SemKirkels/RC_Car/README.md

# RC Car

## Hardware Block Design

RC_BlockDesign-HARDWARE (2)


## Software Block Design


## Pinout

<p align="center">
  Screenshot from 2026-04-26 17-21-20
</p>
