SemKirkels/RC_Car/hardware/datasheets/README.md

# links datasheet

## Drivers

* [drv8306](https://www.ti.com/product/DRV8306?keyMatch=DRV8306&tisearch=universal_search&usecase=GPN-ALT) 
* [mcf8329a](https://www.ti.com/product/MCF8329A)
* [mcf8329a-q1](https://www.ti.com/product/MCF8329A-Q1) (voorkeur)
* [mcf8329hs-q1](https://www.ti.com/product/MCF8329HS-Q1)
* [mct8329a](https://www.ti.com/product/MCT8329A)

## Sensors
* [TOF](https://www.adafruit.com/product/3967)
* [AmbientTEMP](https://www.mouser.be/ProductDetail/Microchip-Technology/MCP9808-E-MS?qs=fgHA1UgJI8CbPdrkP5zjqQ%3D%3D)
* [TEMP](https://www.mouser.be/ProductDetail/Microchip-Technology/MCP9600-E-MX?qs=ZEMkBHnybREkP7PCRsOOMQ%3D%3D)
* [BMC](https://www.mouser.be/ProductDetail/Texas-Instruments/BQ7692006PW?qs=MJut%252BdqOEgjXPi0Ty9wSKA%3D%3D)

## Voltage Regulator
* [3.3VLDO](https://www.mouser.be/ProductDetail/Analog-Devices/LT1764EQPBF?qs=ytflclh7QUW3%252BUOpCc3roQ%3D%3D)
* [5VBuckConverter](https://www.mouser.be/ProductDetail/Texas-Instruments/LM2596SX-5.0-NOPB?qs=X1J7HmVL2ZGZ5T4VcWdmNw%3D%3D)

## GPIO
* [LedDriver](https://www.mouser.be/ProductDetail/Diodes-Incorporated/BCR421UW6Q-7?qs=7rrmt5iGdWdedcb2M%252BEvjA%3D%3D)

## MOSFET halfbridge
* [PSMN4R2-40VSHX](https://www.mouser.be/ProductDetail/Nexperia/PSMN4R2-40VSHX?qs=GCAb4wyKXLKP4GTVQY42wA%3D%3D)

## MOSFET BMC
* [SQJ422EP-T1_BE3](https://www.mouser.be/ProductDetail/Vishay-Siliconix/SQJ422EP-T1_BE3?qs=zW32dvEIR3s9%2FaA%2FvimzvQ%3D%3D)

## Fuze
* [PTS18126V300](https://www.eaton.com/content/dam/eaton/products/electronic-components/resources/data-sheet/eaton-pts1812-6-60-volt-dc-surface-mount-resettable-ptc-data-sheet.pdf)
* [3555-2](https://www.mouser.be/ProductDetail/Keystone-Electronics/3555-2?qs=fP5bVVCrK%2FcbaGNcd%2BfxHA%3D%3D)
