SemKirkels/RC_Car/hardware/BOM_PCB.xlsx

Categorie | Component | Partnummer | website | Aantal | Opmerkingen | prijs per stuk(€) | prijs 1 PCB
Driver | MCF8329A-Q1 | MCF8329A-Q1 | TI (https://www.ti.com/product/DRV8306?keyMatch=DRV8306&tisearch=universal_search&usecase=GPN-ALT) | 1 | Voorkeurscontroller | 1.68 | 1.68
Sensor | TOF | Adafruit 3967 | Adafruit (https://www.adafruit.com/product/3967) | 3 | Time-of-Flight afstandssensor | 12.92 | 38.76
Sensor | AmbientTEMP | MCP9808-E-MS | Mouser (https://www.mouser.be/ProductDetail/Microchip-Technology/MCP9808-E-MS?qs=fgHA1UgJI8CbPdrkP5zjqQ%3D%3D) | 1 | Temperatuur sensor omgeving | 1.2 | 1.2
Sensor | TEMP | MCP9600-E-MX | Mouser (https://www.mouser.be/ProductDetail/Microchip-Technology/MCP9600-E-MX?qs=ZEMkBHnybREkP7PCRsOOMQ%3D%3D) | 1 | Temperatuur sensor | 7.56 | 7.56
Sensor | BMC | BQ7692006PW | Mouser (https://www.mouser.be/ProductDetail/Texas-Instruments/BQ7692006PW?qs=MJut%252BdqOEgjXPi0Ty9wSKA%3D%3D) | 1 | Battery Management Controller | 3.6 | 3.6
Voltage Regulator | 3.3V LDO | LT1764EQPBF | Mouser (https://www.mouser.be/ProductDetail/Analog-Devices/LT1764EQPBF?qs=ytflclh7QUW3%252BUOpCc3roQ%3D%3D) | 2 | LDO regulator 3.3V | 12.29 | 24.58
Voltage Regulator | 5V Buck Converter | LM2596SX-5.0-NOPB | Mouser (https://www.mouser.be/ProductDetail/Texas-Instruments/LM2596SX-5.0-NOPB?qs=X1J7HmVL2ZGZ5T4VcWdmNw%3D%3D) | 1 | Step-down converter 5V | 5.16 | 5.16
GPIO | LED Driver | BCR421UW6Q-7 | Mouser (https://www.mouser.be/ProductDetail/Diodes-Incorporated/BCR421UW6Q-7?qs=7rrmt5iGdWdedcb2M%252BEvjA%3D%3D) | 2 | LED driver IC | 0.292 | 0.584
MOSFET Halfbridge | PSMN4R2-40VSHX | PSMN4R2-40VSHX | Mouser (https://www.mouser.be/ProductDetail/Nexperia/PSMN4R2-40VSHX?qs=GCAb4wyKXLKP4GTVQY42wA%3D%3D) | 3 | N-channel MOSFET halfbridge | 2.25 | 6.75
MOSFET BMC | SQJ422EP-T1_BE3 | SQJ422EP-T1_BE3 | Mouser (https://www.mouser.be/ProductDetail/Vishay-Siliconix/SQJ422EP-T1_BE3?qs=zW32dvEIR3s9%2FaA%2FvimzvQ%3D%3D) | 2 | MOSFET voor BMC | 1.94 | 3.88
Fuze | PTS18126V300 | PTS18126V300 | Mouser (https://www.mouser.be/ProductDetail/Eaton-Electronics/PTS18126V300?qs=QmibqUXyDhQSUADtV47rkw%3D%3D) | 3 | Resettable PTC fuse | 0.215 | 0.645
Fuze | 3555-2 | 3555-2 | Mouser (https://www.mouser.be/ProductDetail/Keystone-Electronics/3555-2?qs=fP5bVVCrK%2FcbaGNcd%2BfxHA%3D%3D) | 1 | fuseholder | 1.31 | 1.31
 |  |  |  |  |  | totaal | 95.709
