SemKirkels/RC_Car/hardware/BOM_RC_CAR.xlsx

CONRAD RC car
Art.naam / omschrijving / Product description | Art.code bij leverancier / Product code | Bestelhoeveelheid en -eenheid (pcs, kg, ...) / Quantity and order unit | Eenheidsprijs (excl. BTW) en munteenheid / Unit price (excl. VAT) | link
Hyper Go MTX10 monstertruck Brushless 1:10 ARTR zwart/blauw | 3339742 - 62 | 1 | €243.80 | https://www.conrad.be/nl/p/hyper-go-mtx10-monstertruck-brushless-1-10-artr-zwart-blauw-3339742.html
11,1 V LiPo-accu 5000 mAh 50 C | 2160923 - 62 | 1 | €37.18 | https://www.conrad.be/nl/p/11-1-v-lipo-accu-5000-mah-50-c-2160923.html
VOLTCRAFT XT60 LiPo Balancer Board | 1516986 - 62 | 1 | €21.48 | https://www.conrad.nl/nl/p/voltcraft-xt60-lipo-balancer-board-uitvoering-lader-xt60-steeksysteem-uitvoering-accupack-bananenstekker-geschikt-voor-1516986.html
Microsoft QAS-00009 N/A | 3384949 - 62 | 1 | €47.93 | https://www.conrad.nl/nl/p/microsoft-qas-00009-n-a-3384949.html
 |  |  | €350.39
