SemKirkels/RC_Car/hardware/RC_Car_PCB/RC_Car_PCB.step

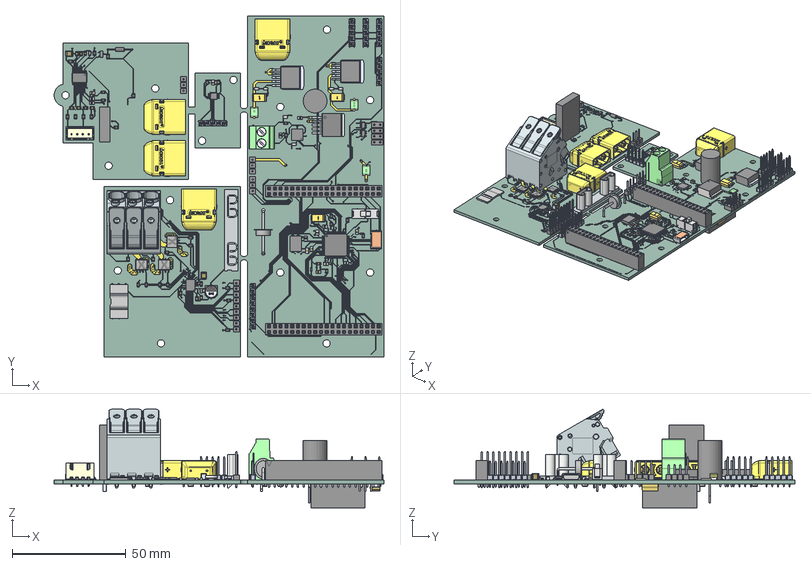
[picture p1: CAD file, 2026-05-19]
hardware/RC_Car_PCB/RC_Car_PCB.step
145.0 x 150.0 x 43.4 mm
solidBody x 17
solidTop x 17
solidTerminal1 x 7
solidTerminal2 x 7
solidTerminal3 x 7
CRCW08052M00JNEA x 6
LeadsArray x 7
C0805C104J4JACAUTO x 12
T491C106M025AT x 3
Terminal x 10
term1 x 12
term2 x 12
ThermalPin x 2
PinsArrayLR x 5
PinsArrayTB x 2
1N5824
EXV226M025A9DAA
C0805X180F8HACAUTO x 2
Pins
D1_Diepad x 3
D2_Diepad x 3
ClipL_G1 x 3
Solder_1 x 3
ClipL_G2 x 3
ClipL_G3 x 3
ClipL_G2_Separate1 x 3
ClipSolde_75pc x 3
NonAA_2 x 3
Solder_1_6 x 3
ClipSolde_75pc_1 x 3
NonAA_2_1 x 3
XT60PW-M x 4
mkds_3-2
C0805C102F3GACTU
LM2596SX-5.0_NOPB
LPattern1[3]_1 x 2
Boss-Extrude3_1 x 2
LPattern1[4]_1 x 2
LPattern1[1]_1 x 2
Cut-Extrude3_1 x 2
Boss-Extrude1_1 x 2
LPattern1[2]_1 x 2
08053C104JAZ2A
PTS18126V300 x 3
EG1218
PSR500HTQFD0L30
B4B-XH-A(LF)(SN) - BODY
B4B-XH-A(LF)(SN) - PIN
ZX62WD1-B-5PC
PinsArrayL
FilletPinR
STM32L476RGT6TR
SimpleBody
Pin1
Pin2
Leads
BODY-TSSOP
LEAD-TSSOP x 20
PIN1
FilletPin1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
