SemKirkels/RC_Car/Mechanical_design/RC_CAR_frame2_top_V2.0.stl

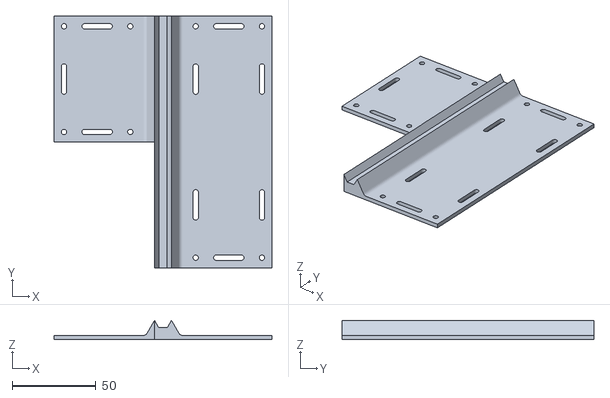
[picture p2: CAD file, 2026-07-30]
Mechanical_design/RC_CAR_frame2_top_V2.0.stl
130.0 x 150.0 x 11.6
