SemKirkels/RC_Car/hardware/RC_Car_PCB/RC_CAR_frame2.0.step

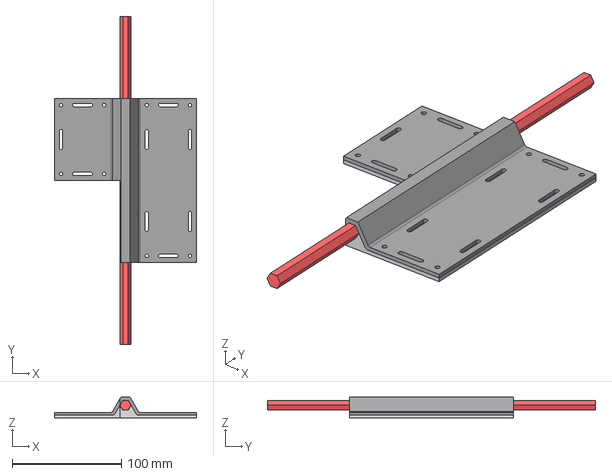
[picture p3: CAD file, 2026-05-19]
hardware/RC_Car_PCB/RC_CAR_frame2.0.step
130.0 x 300.0 x 19.0 mm
