SemKirkels/RC_Car/Mechanical_design/ToF_mount_side.stl

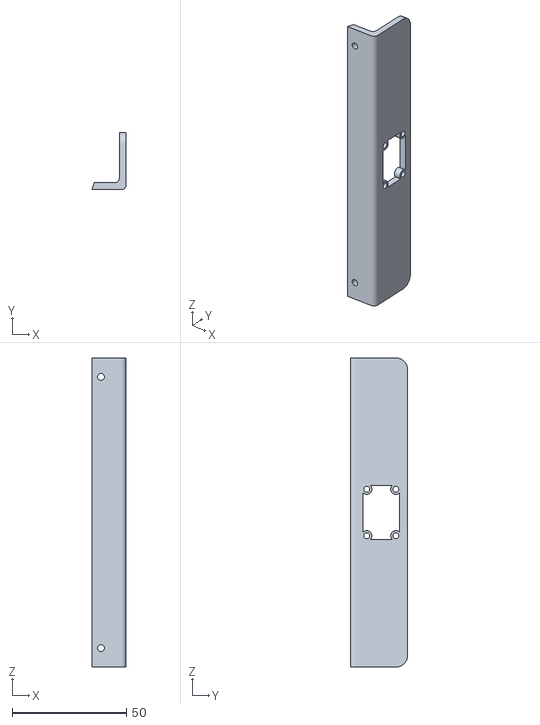
[picture p5: CAD file, 2026-07-30]
Mechanical_design/ToF_mount_side.stl
15.0 x 25.0 x 135.0
