SemKirkels/RC_Car/Mechanical_design/ToF_mounts_one_print.stl

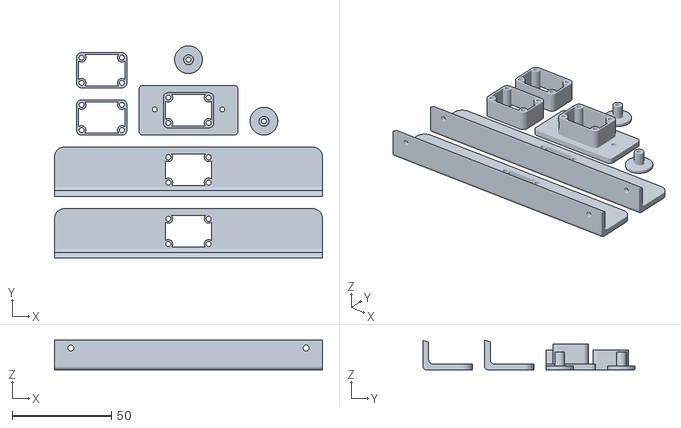
[picture p6: CAD file, 2026-07-30]
Mechanical_design/ToF_mounts_one_print.stl
135.0 x 107.0 x 15.0
