SemKirkels/RC_Car/Mechanical_design/ToF_mount_front.stl

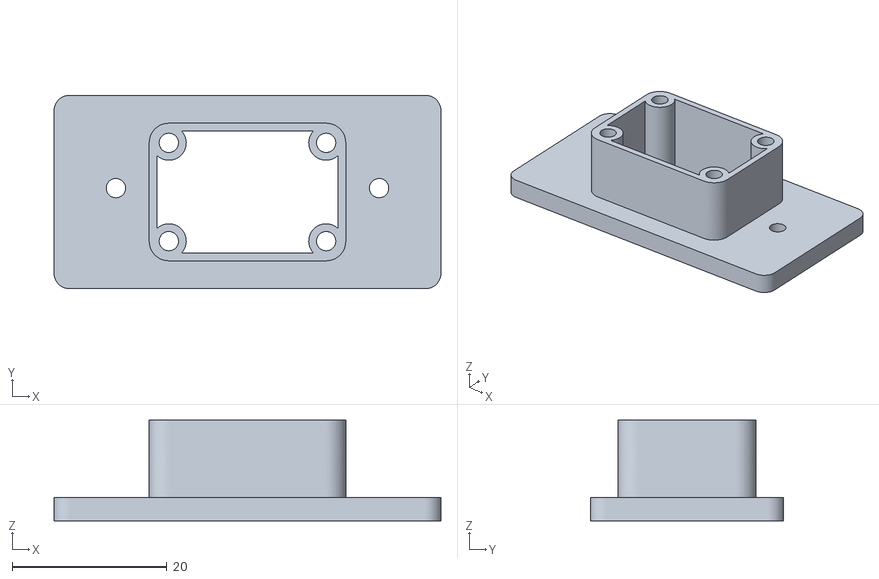
[picture p7: CAD file, 2026-07-30]
Mechanical_design/ToF_mount_front.stl
50.0 x 25.0 x 13.0
