SemKirkels/RC_Car/Mechanical_design/ToF_spacer_side.stl

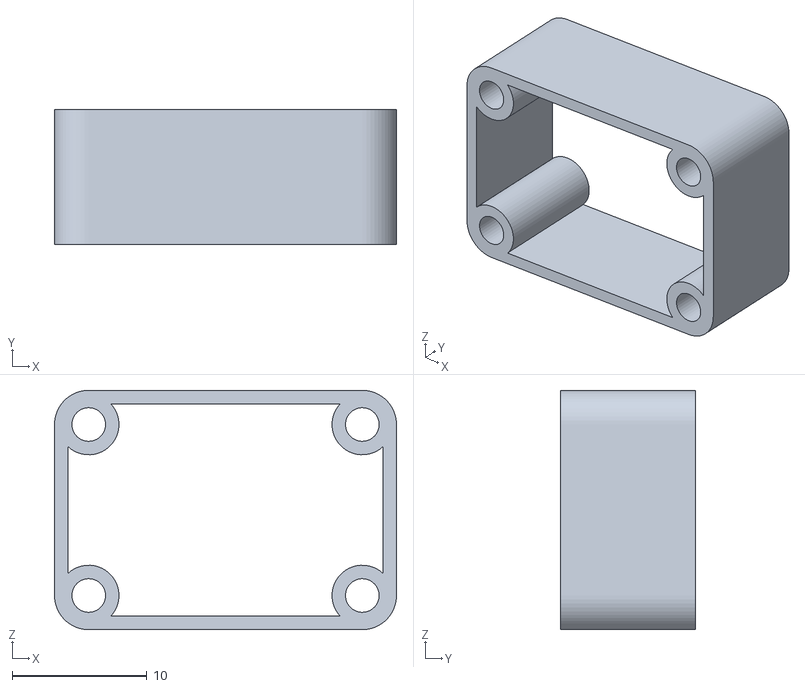
[picture p8: CAD file, 2026-07-30]
Mechanical_design/ToF_spacer_side.stl
25.4 x 10.0 x 17.8
