SemKirkels/RC_Car/Mechanical_design/ToF_spacer_front.stl

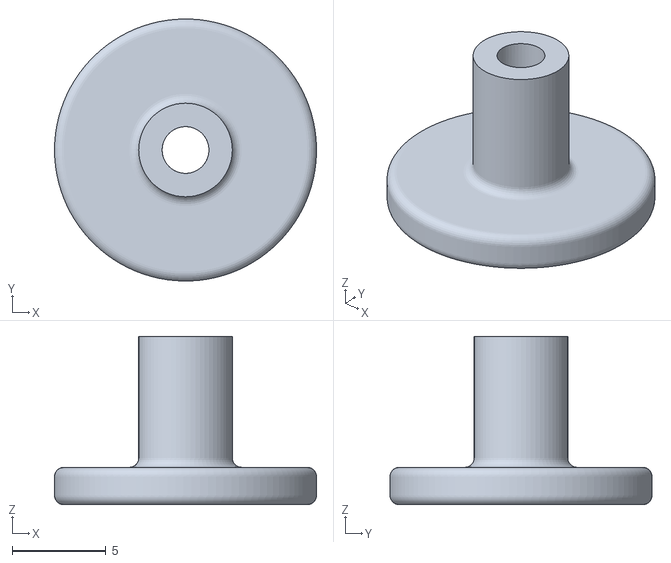
[picture p9: CAD file, 2026-07-30]
Mechanical_design/ToF_spacer_front.stl
14.0 x 14.0 x 9.00
