SemKirkels/RC_Car/Mechanical_design/RC_CAR_SPACERS.stl

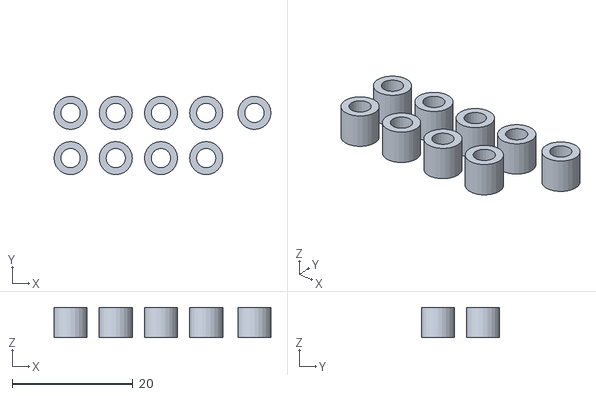
[picture p10: CAD file, 2026-04-30]
Mechanical_design/RC_CAR_SPACERS.stl
36.0 x 13.0 x 5.00
