SemKirkels/RC_Car/(list of files, cad)

Other CAD files:
Mechanical_design/RC_CAR_BOTTOM_MOUNT.stl
Mechanical_design/RC_CAR_Top_MOUNT.stl
Mechanical_design/RC_CAR_frame.f3d
Mechanical_design/RC_CAR_frame2.0.f3d
Mechanical_design/RC_CAR_frame2_V2.0.f3d
Mechanical_design/ToF_mount_front.f3d
Mechanical_design/ToF_mount_side.f3z
Mechanical_design/ToF_spacer_front.f3d
Mechanical_design/ToF_spacer_side.f3d
hardware/RC_Car_PCB/RC_CAR_frame2.0.f3d
