SemKirkels/RC_Car/hardware/BLDC_driver_calculations.pdf

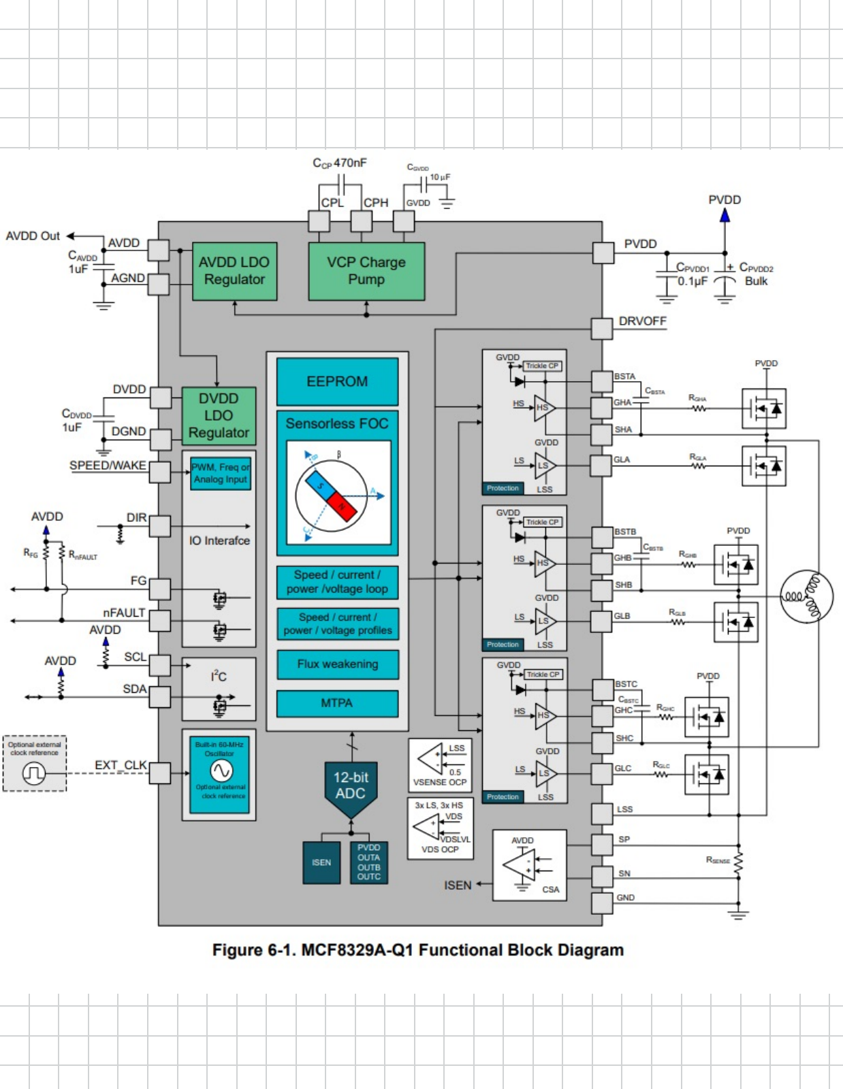
[picture p11: page 2]

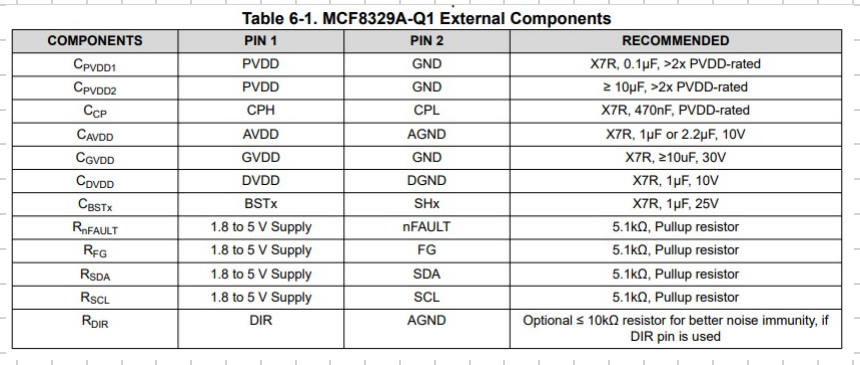
[picture p12: figure]

## Rsens :

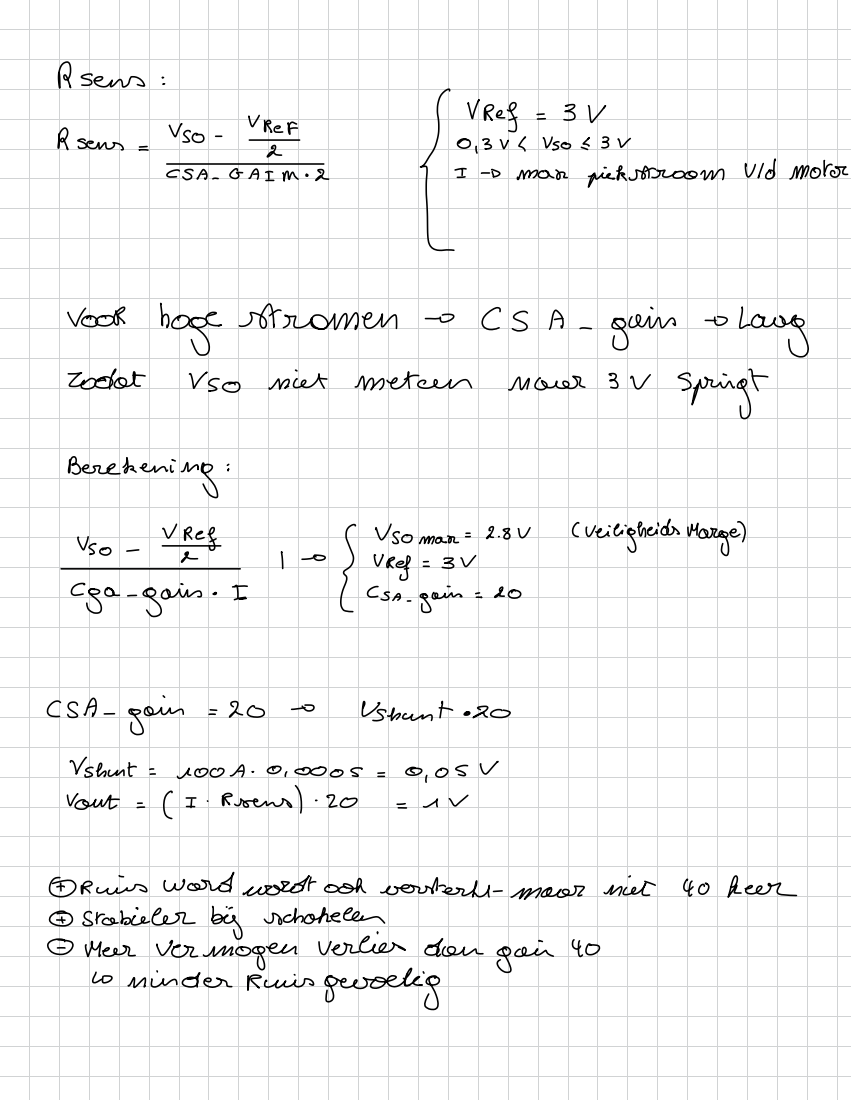
[picture p13: page 4]
VRef; Vref =; Rsens =; Vso-; 0,3V/Vso; { CSA; GAIM; man; pirketroom VId; motor; Voor; hoge stromen; CSA-gain-laug; Zodat; Vso; niet; meten; naur; Springt; Berekening :; Uso-VReg; Ign-gain; 'Nomadou; (veiligheidar; een; CSA-gain; Uspunt ozo; Yshurt; Vout; Brens) .; ①Ruis; word; wordt ook vortertt; maar; heer; ① Stabieler; bij schakelen; ⑦ Mar; Vermogen; Verlies; dan gan; minder; Buis gevoelig

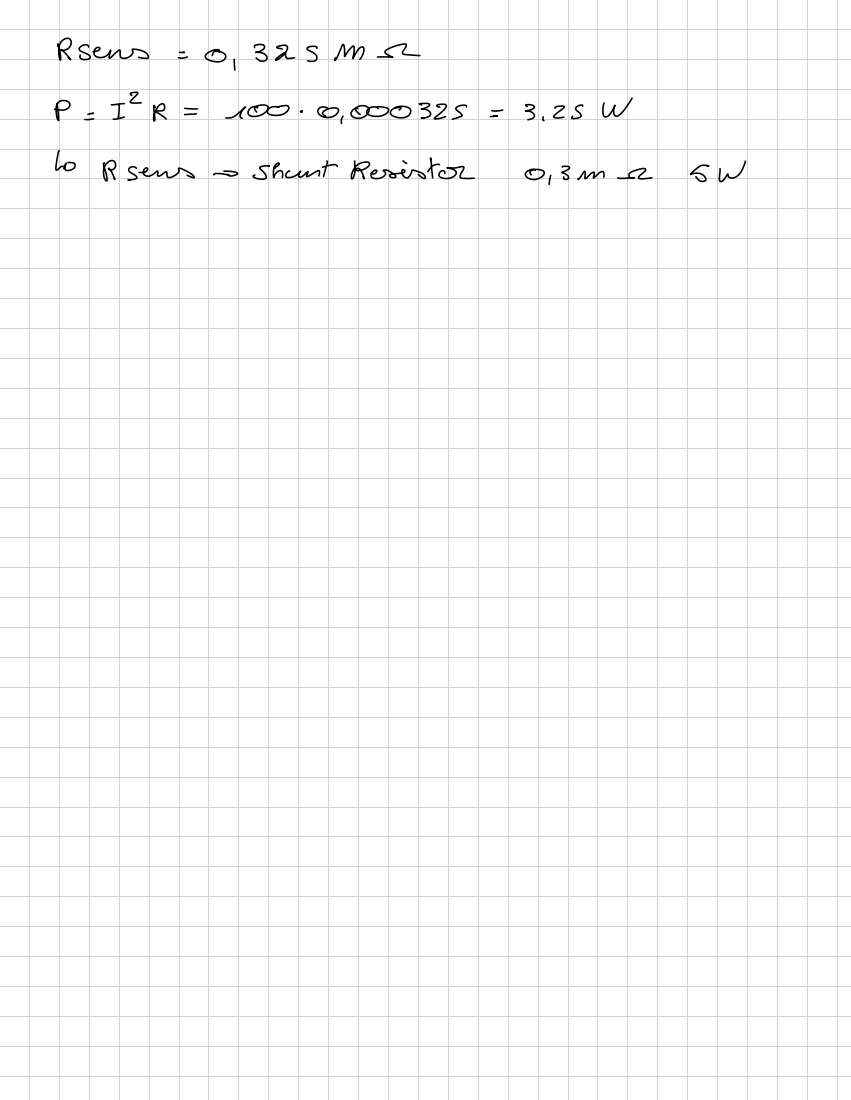
[picture p14: page 5]
Rsens; Rseus; Shunt Resistor

Rotta | -Bepeee
] | ∆

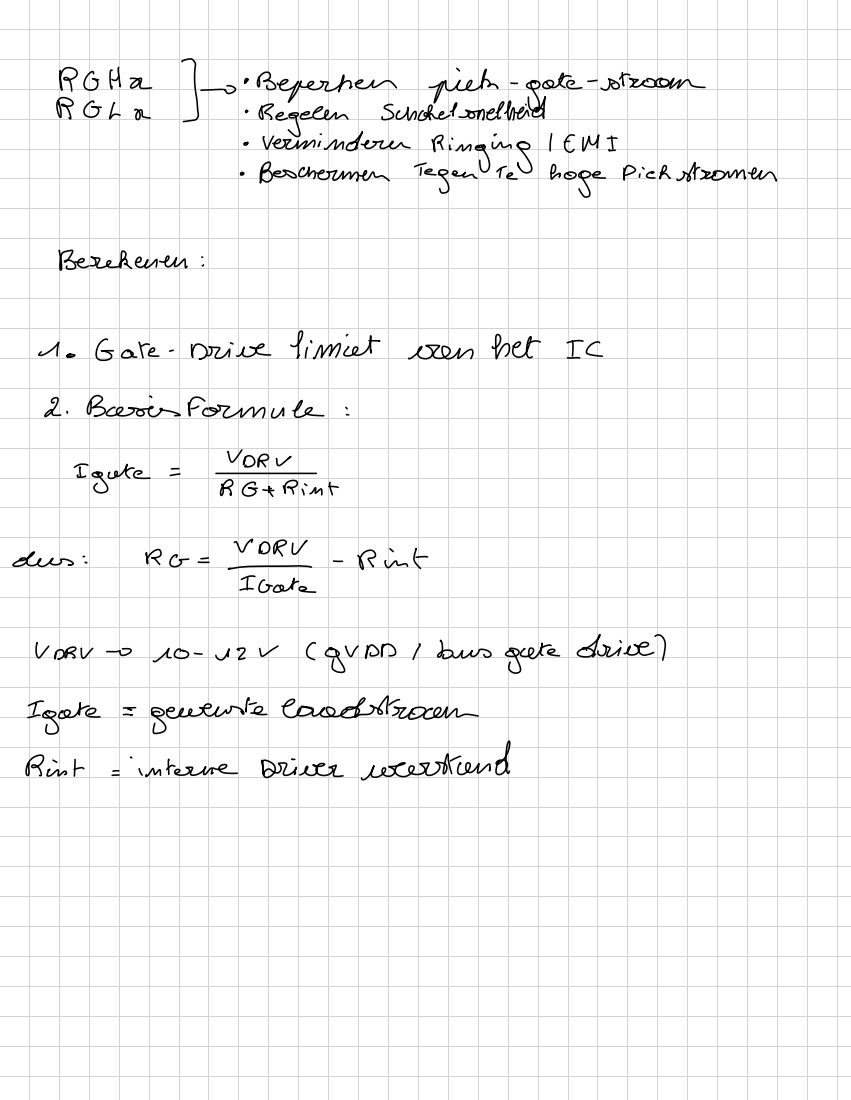
[picture p15: page 6]
Regelen; Schakelsnelheid; verminderen; Ringing/CMI ·; Beschermen; Tegen; hoge Pichetromen; Berekenen :; Gate-Drive limiet; van; het IC; 2. BasisFormule; VDRV; Igute; RG* Rimt; das :; Ro=-Bit; VaRV-o10-v2V; (gVDB/; bus gate; drive?; Igate; geweiste; Godstraum; Rint; interne; Driver; weerstand

pick-gata-stroom

gewenste | schakeltijd | (so-zoons)
Gate | Weerstand | ·

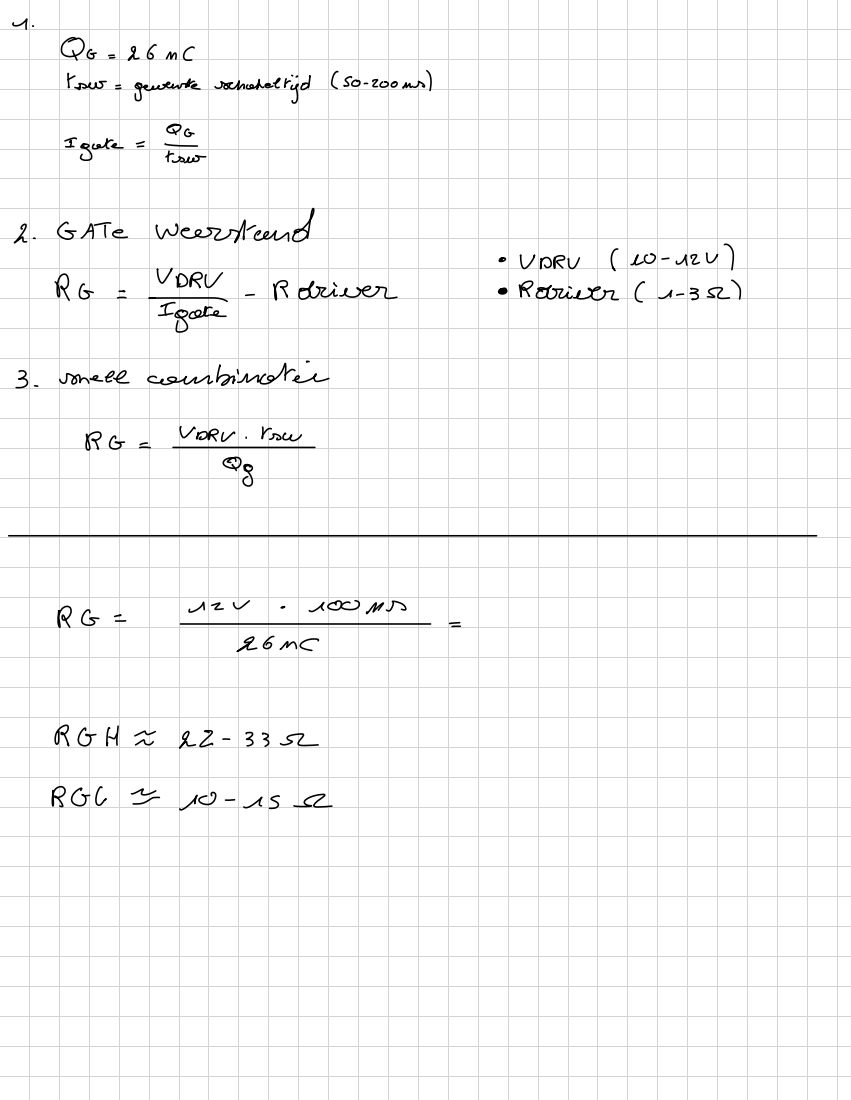
[picture p16: page 7]
Tour =; gute =; tsi; VDRV; Jeo -122]; DR-Robivea; Rociver; sele combinati; VORv.; Yow; RGH; RGG
