SemKirkels/RC_Car/hardware/RC_BlockDesign.pdf

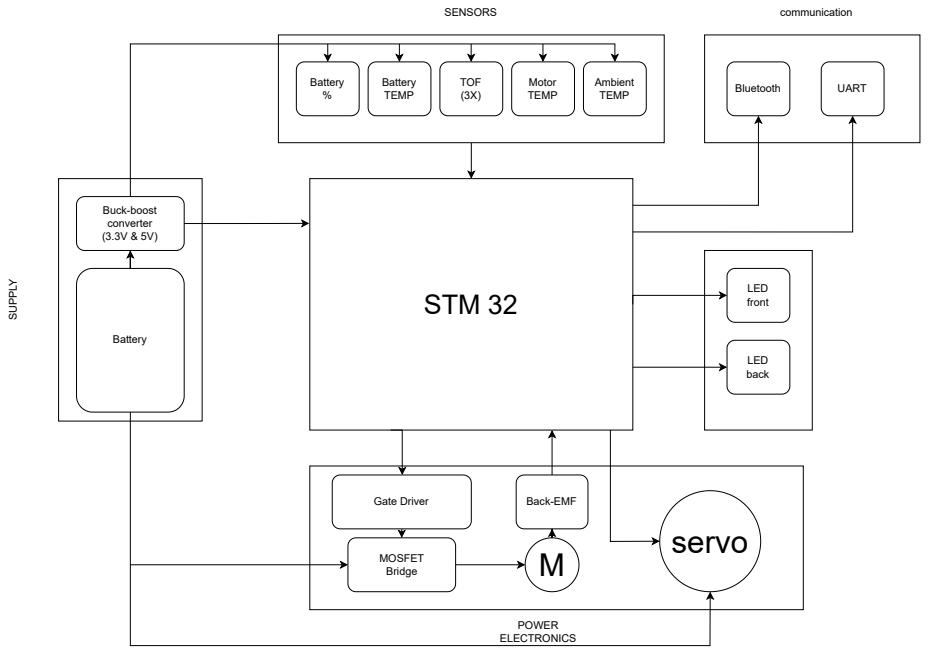
[picture p17: page 1]
SENSORS; Battery %; Battery TEMP; TOF (3X); Motor TEMP; STM 32; LED front; LED back; SUPPLY; Buck-boost converter (3.3V & 5V); Battery; Gate Driver; MOSFET Bridge; Back-EMF; Bluetooth; UART; communication; POWER ELECTRONICS; servo; Ambient TEMP
