SemKirkels/RC_Car/hardware/RC_Car_PCB/RC_Car_PCB.kicad_pcb

## KiCad design hardware/RC_Car_PCB/RC_Car_PCB.kicad_pcb (2026-05-19)

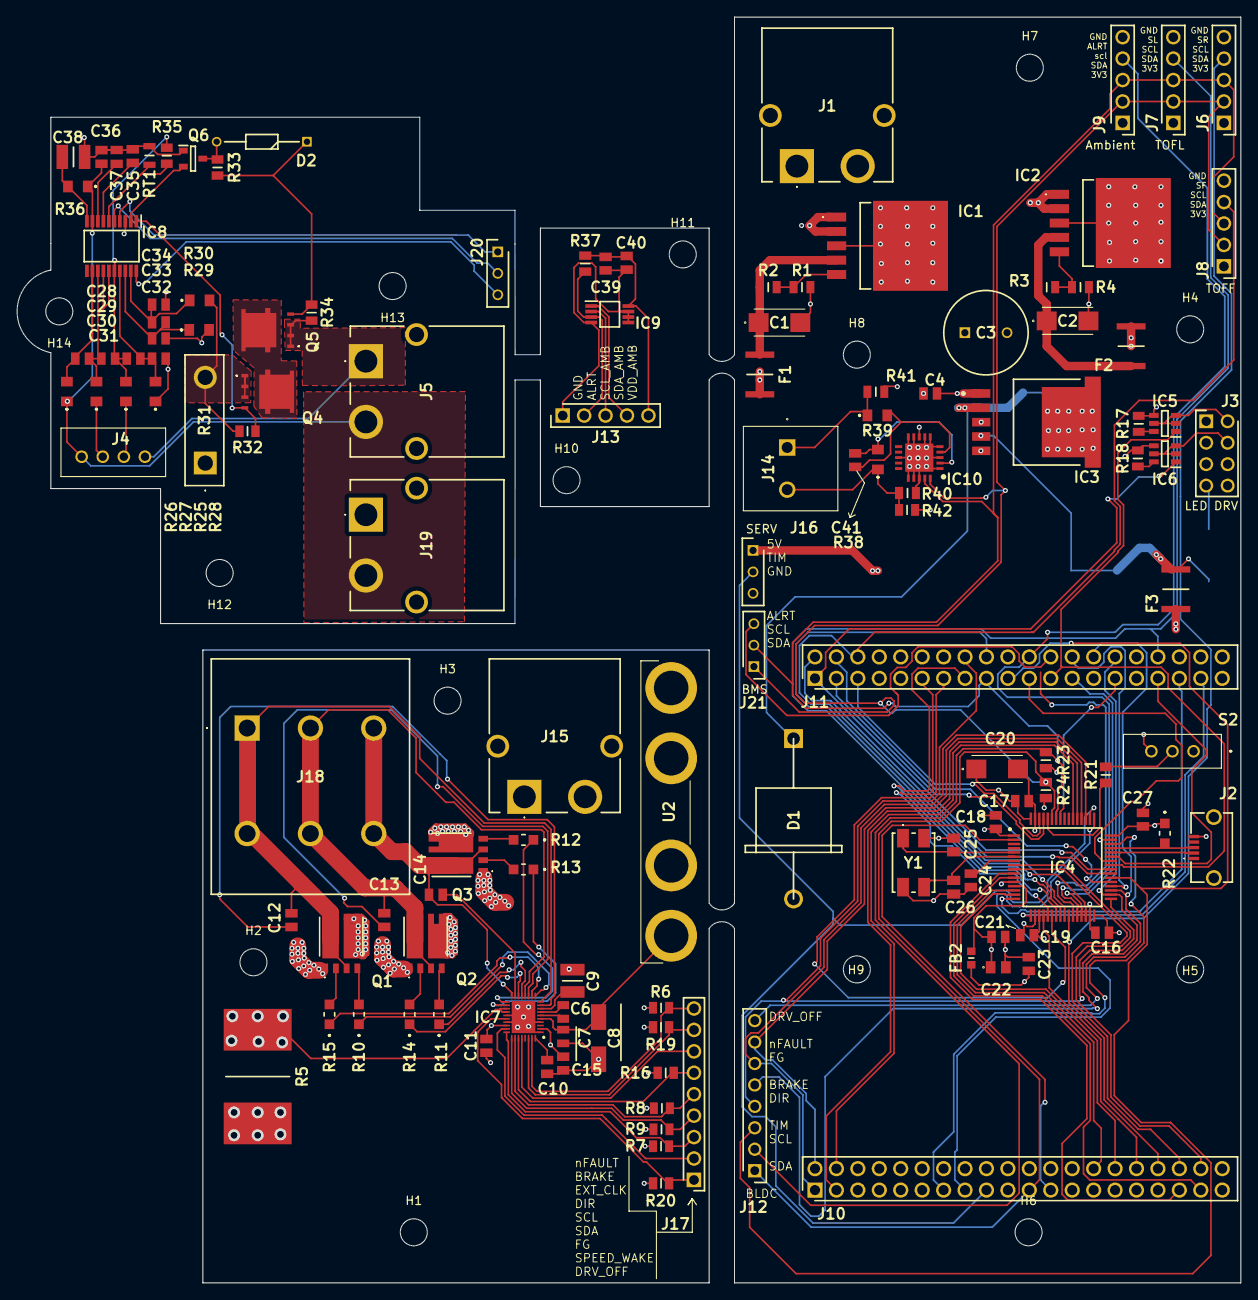
[picture p18: board RC_Car_PCB.kicad_pcb from above]

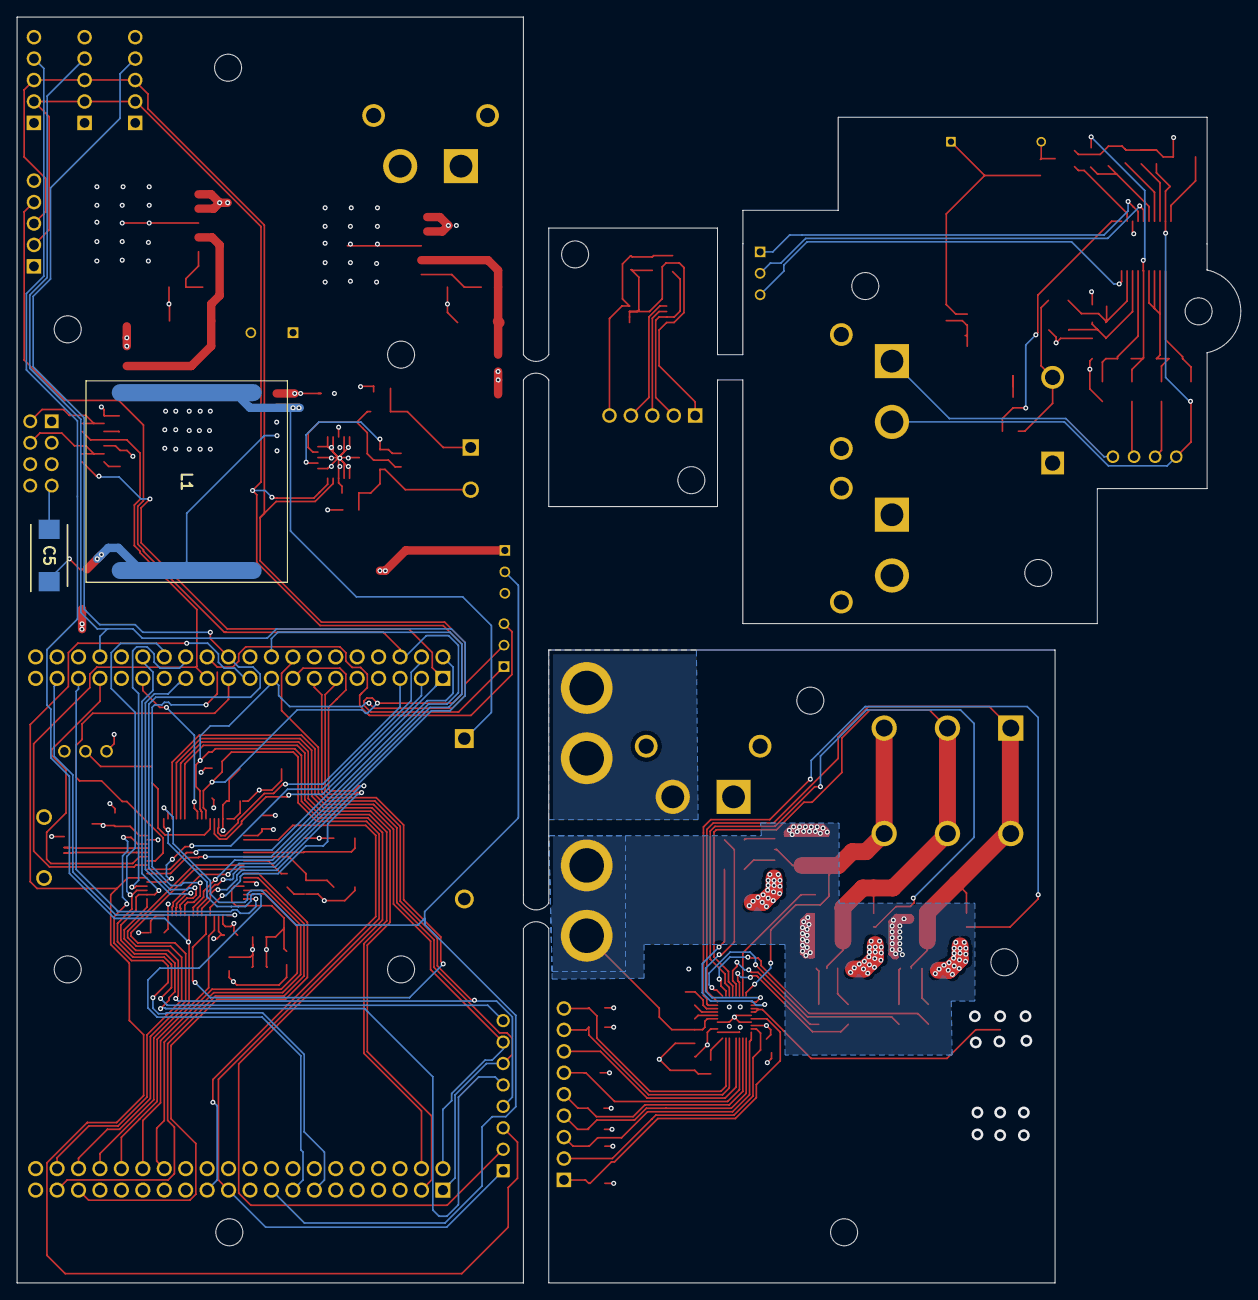
[picture p19: board RC_Car_PCB.kicad_pcb from below]

Board: 4 copper layers, 145.0 x 150.0 mm, 145 parts (2 on the bottom side), 131 nets.

Parts:
C1, C2, C20: 10µF; T491C
C3: 680µF; CAPPRD500W65D1000H1750
C4, C16, C17, C18, C19, C24, C27, C32, C33, C34, C39, C41: 100nF; CAPC2012X140N
C5: 220µF; CAPPM7344X310N
C6: 470nF; CAPC2012X90N
C7: 100nF; CAPC2013X94N
C8: 22µF; EXV106M035A9DAA
C9, C38: 10µF; CAPC3225X285N
C10, C11, C12, C13, C14, C15, C21, C23, C28, C29, C30, C31, C35, C36, C40: 1µF; CAPC2012X94N
C22: 10nF; C0805
C25, C26: 18pF; CAPC2012X98N
C37: 4.7µF; CAPC2012X145N
D1: 1N5824
D2: 1N4148; DIOAD1068W53L380D172
F1, F2, F3: PTS18126V300; FUSC4632X120N
FB2: 600; BEADC1608X95N
H1, H2, H3: MH_Gate_driver; MountingHole_3.2mm_M3_DIN965
H4, H5, H6, H7, H8, H9, H10, H11, H12, H13, H14: MH_STM; MountingHole_3.2mm_M3_DIN965
IC1, IC2: LT1764EQ#PBF; LT1764EQPBF
IC3: LM2596SX-5.0_NOPB; KTT0005B
IC4: STM32L476RGT6TR; QFP50P1200X1200X160-64N
IC5, IC6: BCR421UW6Q-7; SOT95P285X140-6N
IC7: MCF8329A1IREER; QFN40P400X500X80-37N-D
IC8: BQ7692006PW; SOP65P640X120-20N
IC9: MCP9808-E_MS; SOP65P490X110-8N
IC10: MCP9600-E_MX; QFN65P500X500X100-21N-D
J1, J5, J15, J19: XT60PW-M; XT60PWM
J2: ZX62WD1-B-5PC; ZX62WD1B5PC
J3: XG8T-0831; HDRV8W64P254_2X4_1020X500X680P
J4: B4B-XH-A_LF__SN_; B4BXHALFSN
J6, J7, J8, J9, J13: 22-28-4054; HDRV5W66P0X254_1X5_1270X249X1067P
J10, J11: M20-7832042; RHDR40W70P254_2X20_5120X504X850P
J12: 22-28-4083; HDRV8W87P0X254_1X8_2032X249X863P
J14: 1711026
J16, J20, J21: M20-9990345; HDRV3W64P0X254_1X3_762X254X864P
J17: 22-30-3093; HDRV9W66P0X254_1X9_2286X249X1258P
J18: 221391-0003; 2213910003
L1: 38µH; PE54040SNL
Q1, Q2, Q3: PSMN4R2-40VSHX; PSMN4R240VSHX
Q4, Q5: SQJ422EP-T1_BE3; SQJ422EPT1_BE3
Q6: BSS84; SOT95P240X120-3N
R1, R4: 3600; RESC2012X50N
R2, R3: 6200; RESC2012X50N
R5: 300µ; RESC15078X155N
R6, R7, R8, R9: 5.1K; RESC2012X60N
R10, R11, R12, R15: 33; ERA6AEB101V
R13, R14: 30; ERA6AEB101V
R16, R19, R20, R23, R24, R37: 4.7k; RESC2013X65N
R17, R18: 8.06; RESC2012X60N
R21: 10k; RESC2012X70N
R22: 1k5; ERA6AEB101V
R25, R26, R27, R28, R29, R30, R36, R38, R39: 100; ERJP06D1000V
R31: 0.002; FWP21830CR002F
R32, R33, R34: 1M; RESC2012X65N
R35: 20k; RESC2012X65N
R40, R41: 2M; RESC2012X50N
R42: CRCW08051M00JNEAHP; RESC2012X60N
RT1: 10k; THRMC2012X95N
S2: EG1218
U2: 3555-2; 35552
Y1: 8MHz; EA5070LA128000MTR

Connections:
3V3 LDO: F2.2, IC10.8 (VDD), J3.1, J3.3, J6.1, J7.1, J8.1, J9.1, R42.2
3V3 STM: C16.1, C17.1, C18.1, C19.1, C20.1 (+), C21.1, C22.1, C23.1, C27.1, F1.2, FB2.1, FB2.2, IC4.1 (VBAT), IC4.13 (VDDA/VREF+), IC4.19 (VDD_1), IC4.32 (VDD_2), IC4.48 (VDDUSB), IC4.64 (VDD_3), J10.5, J10.33, R22.1, R23.1, R24.1, S2.3 (NO)
5V: F3.2, J16.1
11V1: C3.1 (+), C4.1, C7.1 (C1), C8.1 (+), IC1.1 (~SHDN), IC1.2 (IN), IC2.1 (~SHDN), IC2.2 (IN), IC3.1 (VIN), IC7.5 (PVDD), J1.2, Q1.5 (D1_1), Q1.6 (D1_2), Q1.10 (D1_3), Q2.5 (D1_1), Q2.6 (D1_2), Q2.10 (D1_3), Q3.5 (D1_1), Q3.6 (D1_2), Q3.10 (D1_3), U2.3, U2.4
/LedDriver/LED_driver1: IC5.2 (OUT_1), IC5.3 (OUT_2), IC5.5 (OUT_3), J3.2
/LedDriver/LED_driver2: IC6.2 (OUT_1), IC6.3 (OUT_2), IC6.5 (OUT_3), J3.4
/MCU/ADC1_IN1: IC4.8 (PC0), J10.38
/MCU/ADC1_IN2: IC4.9 (PC1), J10.36
/MCU/ADC1_IN3: IC4.10 (PC2), J10.35
/MCU/ADC1_IN4: IC4.11 (PC3), J10.37
/MCU/ALERT_AMBIENT_TEMP: IC4.28 (PB2), J9.4, J11.22
/MCU/ALERT_BMC: IC4.27 (PB1), J11.24, J21.3
/MCU/BLDC_BRAKE: IC4.34 (PB13), J11.30, J12.5
/MCU/BLDC_DIR: IC4.33 (PB12), J11.16, J12.4
/MCU/BLDC_Drvoff: IC4.35 (PB14), J11.28, J12.8
/MCU/BLDC_FG: IC4.51 (PC10), J10.1, J12.6
/MCU/BLDC_PWM_TIM3_CH2: IC4.38 (PC7), J11.19, J12.3
/MCU/BLDC_nFAULT: IC4.52 (PC11), J10.2, J12.7
/MCU/BOOT0: IC4.60 (BOOT0), R21.2
/MCU/DAC1_OUT1: IC4.20 (PA4), J10.32
/MCU/HSE_IN: C25.1, IC4.5 (PH0-OSC_IN_(PH0)), Y1.1 (CRYSTAL_1)
/MCU/HSE_OUT: C26.1, IC4.6 (PH1-OSC_OUT_(PH1)), Y1.3 (CRYSTAL_2)
/MCU/I2C_SCL_STM: IC4.58 (PB6), IC10.19 (SCL), J6.3, J7.3, J8.3, J9.3, J11.17, J12.2, J21.2, R23.2
/MCU/I2C_SDA_STM: IC4.59 (PB7), IC10.20 (SDA), J6.2, J7.2, J8.2, J9.2, J10.21, J12.1, J21.1, R24.2
/MCU/LED_Front: IC4.41 (PA8), IC5.1 (EN), J11.23
/MCU/LED_Rear: IC4.40 (PC9), IC6.1 (EN), J11.1
/MCU/NRST: C24.1, IC4.7 (NRST)
/MCU/PA2: IC4.16 (PA2), J11.35
/MCU/PA3: IC4.17 (PA3), J11.37
/MCU/PB5: IC4.57 (PB5), J11.29
/MCU/PB8: IC4.61 (PB8), J11.3
/MCU/PB9: IC4.62 (PB9), J11.5
/MCU/PB10: IC4.29 (PB10), J11.25
/MCU/PB11: IC4.30 (PB11), J11.18
/MCU/PB15: IC4.36 (PB15), J11.26
/MCU/PC6: IC4.37 (PC6), J11.4
/MCU/PC8: IC4.39 (PC8), J11.2
/MCU/PC13: IC4.2 (PC13), J10.23
/MCU/SERVO_PWM_TIM2_CH1: IC4.50 (PA15_(JTDI)), J10.17, J16.2
/MCU/SPI1_MISO: IC4.22 (PA6), J11.13
/MCU/SPI1_MOSI: IC4.23 (PA7), J11.15
/MCU/SPI1_SCK: IC4.21 (PA5), J11.11
/MCU/SWCLK: IC4.49 (PA14_(JTCK-SWCLK)), J10.15
/MCU/SWDIO: IC4.46 (PA13_(JTMS-SWDIO)), J10.13
/MCU/SW_BOOT0: R21.1, S2.2 (COMM)
/MCU/TOFxShut_Front: IC4.25 (PC5), J8.4, J11.6
/MCU/TOFxShut_Left: IC4.24 (PC4), J7.4, J11.34
/MCU/TOFxShut_Right: IC4.26 (PB0), J6.4, J10.34
/MCU/UART4_RX: IC4.15 (PA1), J10.30
/MCU/UART4_TX: IC4.14 (PA0), J10.28
/MCU/UART5_RX: IC4.54 (PD2), J10.4
/MCU/UART5_TX: IC4.53 (PC12), J10.3
/MCU/USART1_RX: IC4.43 (PA10), J11.33
/MCU/USART1_TX: IC4.42 (PA9), J11.21
/MCU/USB_D+: IC4.45 (PA12), J2.3, R22.2
/MCU/USB_D-: IC4.44 (PA11), J2.2
/Power Electronics/AVDD: C11.1, C15.1, IC7.2 (VREG), IC7.26 (AVDD), R6.2, R7.2, R8.2, R9.2
/Power Electronics/BRAKE: IC7.34 (BRAKE), J17.8, R19.1
/Power Electronics/DIR: IC7.31 (DIR), J17.6, R16.1
/Power Electronics/DRVOFF: IC7.24 (DRVOFF), J17.1, R20.1
/Power Electronics/EXT_CLK: IC7.32 (EXT_CLK), J17.7
/Power Electronics/FG: IC7.28 (FG), J17.3, R7.1
/Power Electronics/M_A: C12.2, IC7.10 (SHA), J18.1, J18.2, Q1.3 (S1), Q1.7 (S1_D2_1), Q1.8 (S1_D2_2), Q1.9 (S1_D2_3)
/Power Electronics/M_B: C13.2, IC7.14 (SHB), J18.3, J18.4, Q2.3 (S1), Q2.7 (S1_D2_1), Q2.8 (S1_D2_2), Q2.9 (S1_D2_3)
/Power Electronics/M_C: C14.2, IC7.18 (SHC), J18.5, J18.6, Q3.3 (S1), Q3.7 (S1_D2_1), Q3.8 (S1_D2_2), Q3.9 (S1_D2_3)
/Power Electronics/NFAULT: IC7.35 (NFAULT), J17.9, R6.1
/Power Electronics/SCL_driver: IC7.30 (SCL), J17.5, R8.1
/Power Electronics/SDA_driver: IC7.29 (SDA), J17.4, R9.1
/Power Electronics/SPEED/WAKE: IC7.27 (SPEED/WAKE), J17.2
/Sensors/ALERT_AMB: IC9.3 (ALERT), J13.2, R37.2
/Sensors/ALERT_BMS: IC8.20 (ALERT), J20.3
/Sensors/GND(ambient): C39.2, C40.2, IC9.4 (GND), IC9.5 (A2), IC9.6 (A1), IC9.7 (A0), J13.1
/Sensors/LOAD+: C36.1, IC8.9 (REGSRC), J4.1, J5.2, J19.2, R26.1, R36.1
/Sensors/PACK-: J4.4, J5.1, Q5.1 (S_1), Q5.2 (S_2), Q5.3 (S_3), R34.2
/Sensors/SCL_Ambient: IC9.2 (SCL), J13.3
/Sensors/SCL_BMS: IC8.5 (SCL), J20.2
/Sensors/SDA_Ambient: IC9.1 (SDA), J13.4
/Sensors/SDA_BMS: IC8.4 (SDA), J20.1
/Sensors/TS1: C29.2, C30.1, IC8.16 (VC1), R25.2, R35.2
/Sensors/VDD_ambient: C39.1, C40.1, IC9.8 (VDD), J13.5, R37.1
/Sensors/cel1-2: J4.3, R25.1
/Sensors/cel2-3: J4.2, R27.1
GND: C1.2 (-), C2.2 (-), C3.2 (-), C4.2, C5.2 (-), C7.2 (C2), C8.2 (-), C9.2, C10.2, C11.2, C15.2, C16.2, C17.2, C18.2, C19.2, C20.2 (-), C21.2, C22.2, C23.2, C24.2, C25.2, C26.2, C27.2, C31.2, C32.1, C34.2, C35.2, C36.2, C37.2, C38.2, D1.2 (A), IC1.3 (GND_1), IC1.6 (GND_2), IC2.3 (GND_1), IC2.6 (GND_2), IC3.3 (GND), IC3.5 (~ON_/_OFF), IC3.6 (TAB_(GND)), IC4.12 (VSSA/VREF-), IC4.18 (VSS_1), IC4.31 (VSS_2), IC4.47 (VSS_3), IC4.63 (VSS_4), IC5.4 (GND), IC6.4 (GND), IC7.1 (DGND), IC7.4 (GND_1), IC7.23 (SN), IC7.25 (AGND), IC7.37 (GND_2), IC8.3 (VSS), IC10.1 (GND_1), IC10.3 (GND_2), IC10.5 (GND_3), IC10.6 (GND_4), IC10.7 (GND_5), IC10.9 (GND_6), IC10.10 (GND_7), IC10.13 (GND_8), IC10.16 (ADDR), IC10.17 (GND_9), IC10.18 (GND_10), IC10.21 (EP), J1.1, J1.3 (MH1), J1.4 (MH2), J2.5, J2.MH1, J2.MH2, J3.5, J3.6, J3.7, J3.8, J6.5, J7.5, J8.5, J9.5, J10.8, J10.19, J10.20, J10.22, J10.39, J10.40, J11.9, J11.20, J11.32, J11.39, J11.40, J15.1, J15.3 (MH1), J15.4 (MH2), J16.3, J19.1, Q6.1 (G), R1.2, R4.2, R5.2, R16.2, R17.2, R18.2, R19.2, R20.2, R28.1, R29.2, R31.1, R40.1, R41.1, RT1.2, S2.1 (NC), Y1.2 (COVER/GROUND_1), Y1.4 (COVER/GROUND_2)
unnamed: C1.1 (+), F1.1, IC1.4 (OUT), R2.1
unnamed: C2.1 (+), F2.1, IC2.4 (OUT), R3.1
unnamed: C5.1 (+), F3.1, IC3.4 (FEED_BACK), L1.2
unnamed: D1.1 (K), IC3.2 (OUTPUT), L1.1
unnamed: D2.2 (A), Q6.3 (D), R33.1
unnamed: D2.1 (K), Q5.4 (G), R33.2, R34.1
unnamed: IC1.5 (ADJ), R1.1, R2.2
unnamed: IC2.5 (ADJ), R3.2, R4.1
unnamed: IC5.6 (REXT), R17.1
unnamed: IC6.6 (REXT), R18.1
unnamed: C12.1, IC7.9 (BSTA)
unnamed: C13.1, IC7.13 (BSTB)
unnamed: C14.1, IC7.17 (BSTC)
unnamed: C6.2, IC7.7 (CPH)
unnamed: C6.1, IC7.6 (CPL)
unnamed: C10.1, IC7.36 (DVDD)
unnamed: IC7.11 (GHA), R10.1
unnamed: IC7.15 (GHB), R11.1
unnamed: IC7.19 (GHC), R12.1
unnamed: IC7.12 (GLA), R15.1
unnamed: IC7.16 (GLB), R14.1
unnamed: IC7.20 (GLC), R13.1
unnamed: C9.1, IC7.8 (GVDD)
unnamed: IC7.21 (LSS), IC7.22 (SP), Q1.1 (S2), Q2.1 (S2), Q3.1 (S2), R5.1
unnamed: C38.1, IC8.10 (BAT), R36.2
unnamed: C35.1, IC8.7 (CAP1)
unnamed: IC8.2 (CHG), Q6.2 (S)
unnamed: IC8.1 (DSG), Q4.4 (G), R32.1
unnamed: C37.1, IC8.8 (REGOUT)
unnamed: C33.2, C34.1, IC8.19 (SRN), R30.1
unnamed: C32.2, C33.1, IC8.18 (SRP), R29.1
unnamed: IC8.6 (TS1), R35.1, RT1.1
unnamed: C30.2, C31.1, IC8.17 (VC0), R28.2
unnamed: C28.2, C29.1, IC8.13 (VC4), IC8.14 (VC3), IC8.15 (VC2), R27.2
unnamed: C28.1, IC8.12 (VC5), R26.2
unnamed: C41.1, IC10.2 (VIN+), R38.2
unnamed: C41.2, IC10.4 (VIN-), R39.2
unnamed: J14.1, R39.1, R41.2
unnamed: J14.2, R38.1, R40.2, R42.1
unnamed: J15.2, U2.1, U2.2
unnamed: Q1.4 (G1), R10.2
unnamed: Q1.2 (G2), R15.2
unnamed: Q2.4 (G1), R11.2
unnamed: Q2.2 (G2), R14.2
unnamed: Q3.4 (G1), R12.2
unnamed: Q3.2 (G2), R13.2
unnamed: Q4.5 (D_1), Q4.6 (D_2), Q4.7 (D_3), Q4.8 (D_4), Q5.5 (D_1), Q5.6 (D_2), Q5.7 (D_3), Q5.8 (D_4)
unnamed: Q4.1 (S_1), Q4.2 (S_2), Q4.3 (S_3), R30.2, R31.2, R32.2
