SemKirkels/RC_Car/software/cubeIDE/main.cpp

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
/* Includes ------------------------------------------------------------------*/
#include "main.h"
#include "cmsis_os.h"

/* USER CODE BEGIN Includes */
#include "car.h"
#include "rc_config.h"
#include "tofTask.h"
#include "healthTask.h"
#include "i2cDevice.h"
/* USER CODE END Includes */

I2C_HandleTypeDef hi2c1;
DMA_HandleTypeDef hdma_i2c1_rx;
DMA_HandleTypeDef hdma_i2c1_tx;

TIM_HandleTypeDef htim2;
TIM_HandleTypeDef htim3;

UART_HandleTypeDef huart4;
UART_HandleTypeDef huart1;
DMA_HandleTypeDef hdma_uart4_rx;

PCD_HandleTypeDef hpcd_USB_OTG_FS;

/* Definitions for defaultTask */
osThreadId_t defaultTaskHandle;
const osThreadAttr_t defaultTask_attributes = {
  .name = "defaultTask",
  .stack_size = 512 * 4,
  .priority = (osPriority_t) osPriorityAboveNormal,
};
/* USER CODE BEGIN PV */
Car car(
	/* ESP Communication */
    &huart4,
	/* Steering PWM */
    &htim2,
	TIM_CHANNEL_1,
	/* LEDs */
    GPIOC,
	LED_Front_Pin,
    GPIOC,
	LED_Rear_Pin,
	/* Motor driver */
	&htim3,
	TIM_CHANNEL_2,
	GPIOB,
	BLDC_Dir_Pin,
	GPIOB,
	BLDC_Brake_Pin,
	GPIOB,
	BLDC_Drvoff_Pin
);
/* Front LEDs */
GpioDrive leds_front(GPIOC, GPIO_PIN_8);
/* Rear LEDs */
GpioDrive leds_rear(GPIOC, GPIO_PIN_9);

/* Gamepad parser */
GamepadParser gamepad(&huart4);

/* USER CODE END PV */

void SystemClock_Config(void);
void PeriphCommonClock_Config(void);
static void MX_GPIO_Init(void);
static void MX_DMA_Init(void);
static void MX_I2C1_Init(void);
static void MX_TIM2_Init(void);
static void MX_TIM3_Init(void);
static void MX_UART4_Init(void);
static void MX_USART1_UART_Init(void);
static void MX_USB_OTG_FS_PCD_Init(void);
void StartDefaultTask(void *argument);

/* USER CODE BEGIN PFP */
static void InitConfiguredPeripherals(void);
/* USER CODE END PFP */

/**
  * @brief  The application entry point.
  * @retval int
  */
int main(void)
{

  /* MCU Configuration--------------------------------------------------------*/

  /* Reset of all peripherals, Initializes the Flash interface and the Systick. */
  HAL_Init();

  /* Configure the system clock */
  SystemClock_Config();

  /* Configure the peripherals common clocks */
  PeriphCommonClock_Config();

  /* USER CODE BEGIN SysInit */
  uint8_t msg[] = "Starting Default task, setting up car\r\n";
  HAL_UART_Transmit(&huart1, msg, sizeof(msg)-1, HAL_MAX_DELAY);
  /* USER CODE END SysInit */

  /* Initialize all configured peripherals */

  /* USER CODE BEGIN 2 */
  InitConfiguredPeripherals();
  /* USER CODE END 2 */

  /* Init scheduler */
  osKernelInitialize();

  /* USER CODE BEGIN RTOS_MUTEX */
  /* add mutexes, ... */
  /* USER CODE END RTOS_MUTEX */

  /* USER CODE BEGIN RTOS_SEMAPHORES */
  /* add semaphores, ... */

  /* USER CODE END RTOS_SEMAPHORES */

  /* USER CODE BEGIN RTOS_TIMERS */
  /* start timers, add new ones, ... */
  /* USER CODE END RTOS_TIMERS */

  /* USER CODE BEGIN RTOS_QUEUES */
  /* add queues, ... */
  /* USER CODE END RTOS_QUEUES */

  /* Create the thread(s) */
  /* creation of defaultTask */
  defaultTaskHandle = osThreadNew(StartDefaultTask, NULL, &defaultTask_attributes);
  /* USER CODE BEGIN RTOS_THREADS */
  /* add threads, ... */
  osThreadAttr_t tofAttr = {};
  tofAttr.name       = "ToFTask";
  tofAttr.stack_size = 1024 * 4;
  tofAttr.priority   = osPriorityAboveNormal;
  osThreadNew(StartToFTask, NULL, &tofAttr);

  osThreadAttr_t healthAttr = {};
  healthAttr.name       = "HealthTask";
  healthAttr.stack_size = 1024 * 4;
  healthAttr.priority   = osPriorityNormal;
  osThreadNew(StartHealthTask, NULL, &healthAttr);
  /* USER CODE END RTOS_THREADS */

  /* USER CODE BEGIN RTOS_EVENTS */
  /* add events, ... */
  /* USER CODE END RTOS_EVENTS */

  /* Start scheduler */
  osKernelStart();

  /* We should never get here as control is now taken by the scheduler */

  /* Infinite loop */
  /* USER CODE BEGIN WHILE */


  while (1)
  {
    /* USER CODE END WHILE */

    /* USER CODE BEGIN 3 */
  }
  /* USER CODE END 3 */
}

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
/* USER CODE BEGIN 4 */
/************/
/*USER CODE */
/************/
extern GamepadParser gamepad;

void HAL_UARTEx_RxEventCallback(UART_HandleTypeDef *huart, uint16_t Size){
    if(huart->Instance == UART4){
    	car.uartRxCallback(Size);
    }
}

void HAL_I2C_MasterRxCpltCallback(I2C_HandleTypeDef *hi2c){
    if(hi2c->Instance == I2C1 && I2cDevice::s_activeDevice != NULL){
        I2cDevice::s_activeDevice->onDmaComplete();
        I2cDevice::s_activeDevice = NULL;
    }
}

static void InitConfiguredPeripherals(void){
	#if GPIO_ENABLE
		MX_GPIO_Init();
	#endif

	MX_DMA_Init();

	#if I2C1_ENABLE
	  MX_I2C1_Init();
	#endif

	#if STEERING_PWM_ENABLE
	  MX_TIM2_Init();
	#endif

	#if MOTOR_PWM_ENABLE
	  MX_TIM3_Init();
	#endif

	#if ESP_COMM_ENABLE
	  MX_UART4_Init();
	#endif

	#if DEBUG_COMM_ENABLE
	  MX_USART1_UART_Init();
	#endif

//	MX_USB_OTG_FS_PCD_Init();
}
/* USER CODE END 4 */

/* USER CODE BEGIN Header_StartDefaultTask */
/**
  * @brief  Function implementing the defaultTask thread.
  * @param  argument: Not used
  * @retval None
  */
/* USER CODE END Header_StartDefaultTask */
void StartDefaultTask(void *argument)
{
  /* USER CODE BEGIN 5 */
  uint8_t msg[] = "Starting Default task, setting up car\r\n";
  HAL_UART_Transmit(&huart1, msg, sizeof(msg)-1, HAL_MAX_DELAY);

  car.init();

  /* Send start condition to ESP32 */
  uint8_t ready = 'R';
  HAL_UART_Transmit(&huart4, &ready, 1, HAL_MAX_DELAY);

  /* Infinite loop */
  for(;;){
	car.update();
  }
  /* USER CODE END 5 */
}

/**
  * @brief  Period elapsed callback in non blocking mode
  * @note   This function is called  when TIM6 interrupt took place, inside
  * HAL_TIM_IRQHandler(). It makes a direct call to HAL_IncTick() to increment
  * a global variable "uwTick" used as application time base.
  * @param  htim : TIM handle
  * @retval None
  */
void HAL_TIM_PeriodElapsedCallback(TIM_HandleTypeDef *htim)
{
  if (htim->Instance == TIM6)
  {
    HAL_IncTick();
  }
}

/**
  * @brief  This function is executed in case of error occurrence.
  * @retval None
  */
void Error_Handler(void)
{
  /* USER CODE BEGIN Error_Handler_Debug */
  /* User can add his own implementation to report the HAL error return state */
  __disable_irq();
  while (1)
  {
  }
  /* USER CODE END Error_Handler_Debug */
}
#ifdef USE_FULL_ASSERT
/**
  * @brief  Reports the name of the source file and the source line number
  *         where the assert_param error has occurred.
  * @param  file: pointer to the source file name
  * @param  line: assert_param error line source number
  * @retval None
  */
void assert_failed(uint8_t *file, uint32_t line)
{
  /* USER CODE BEGIN 6 */
  /* User can add his own implementation to report the file name and line number,
     ex: printf("Wrong parameters value: file %s on line %d\r\n", file, line) */
  /* USER CODE END 6 */
}
#endif /* USE_FULL_ASSERT */
