SemKirkels/RC_Car/software/cubeIDE/rc_car.ioc

Mcu.UserName=STM32L476RGTx
PA0.Signal=UART4_TX
PA1.Signal=UART4_RX
PA10.Signal=USART1_RX
PA11.Signal=USB_OTG_FS_DM
PA12.Signal=USB_OTG_FS_DP
PA9.Signal=USART1_TX
PB0.GPIO_Label=TOF xshut Right
PB0.Signal=GPIO_Output
PB1.GPIO_Label=Alert_BMC
PB1.Signal=GPIO_Input
PB12.GPIO_Label=BLDC Dir
PB12.Signal=GPXTI12
PB13.GPIO_Label=BLDC Brake
PB13.Signal=GPIO_Output
PB14.GPIO_Label=BLDC Drvoff
PB14.Signal=GPIO_Output
PB2.GPIO_Label=Alert_Ambient_Temp
PB2.Signal=GPIO_Input
PB6.Signal=I2C1_SCL
PB7.Signal=I2C1_SDA
PC10.GPIO_Label=BLDC FG
PC10.Signal=GPIO_Input
PC11.GPIO_Label=BLDC NFault
PC11.Signal=GPIO_Input
PC4.GPIO_Label=TOF xshut Left
PC4.Signal=GPIO_Output
PC5.GPIO_Label=TOF xshut Front
PC5.Signal=GPIO_Output
PC7.GPIO_Label=TIM3_CH2 (BLDC PWM)
PC7.Signal=S_TIM3_CH2
PC8.GPIO_Label=LED Front
PC8.Signal=GPIO_Output
PC9.GPIO_Label=LED Rear
PC9.Signal=GPIO_Output
