SemKirkels/RC_Car/software/classes_template/inc/car.h

#ifndef CAR_H
#define CAR_H

#include "main.h"
#include "rc_config.h"
#include "cmsis_os.h"
#include "gamepadParser.h"
#include "steering.h"
#include "gpioDrive.h"
#include "motor.h"
#include <cstdio>
#include <cstring>

extern UART_HandleTypeDef huart1;
extern UART_HandleTypeDef huart4;

/* TOF Struct */
struct DistanceMap{
    uint16_t front;
    uint16_t left;
    uint16_t right;
};

/* Health sensors struct */
struct HealthMap{
    float   motorTempHot;
    float   motorTempCold;
    float   ambientTemp;
    float   cellVoltage[3];
    float   totalVoltage;
    float   current;
    uint8_t bmsStatus;
};

class Car{
    public:
        Car(
            UART_HandleTypeDef* huart,
            TIM_HandleTypeDef*  steeringTim,
            uint32_t            steeringChannel,
            GPIO_TypeDef*       ledFrontPort, 
            uint16_t            ledFrontPin,
            GPIO_TypeDef*       ledRearPort, 
            uint16_t            ledRearPin,
            TIM_HandleTypeDef*  motorTim,
            uint32_t            motorChannel,
            GPIO_TypeDef*       dirPort,
            uint16_t            dirPin,
            GPIO_TypeDef*       brakePort,
            uint16_t            brakePin,
            GPIO_TypeDef*       drvoffPort,
            uint16_t            drvoffPin
        );
        void init();
        void update();

        /* Uart callback */
        void uartRxCallback(uint16_t size);

        /* TOF */
        void setDistances(const DistanceMap& distances);

        /* Health */
        void setHealth(const HealthMap& health);
    private:
        GamepadParser   m_gamepad;
        Steering        m_steering;
        GpioDrive       m_ledFront;
        GpioDrive       m_ledRear;
        Motor           m_motor;

        bool            m_prevX;
        bool            m_prevB;

        DistanceMap     m_distances;
        osMutexId_t     m_distanceMutex;

        HealthMap       m_health;
        osMutexId_t     m_healthMutex;

        uint32_t        m_lastTelemetry;

        void sendTelemetry();
};

#endif
