SemKirkels/RC_Car/software/classes_template/address.h

#ifndef ADDRESS_H
#define ADDRESS_H

/* Temperature sensors */
#define TEMP_MOTOR_ADDR     0x00
#define TEMP_BATTERY_ADDR   0x00
#define TEMP_AMBIENT_ADDR   0x00

/* TOF sensors */
#define TOF_FRONT_ADDR      0x00
#define TOF_LEFT_ADDR       0x00
#define TOF_RIGHT_ADDR      0x00

#endif
