SemKirkels/RC_Car/(commit log)

2026-03-15 BOM
    bill of material RC car
2026-03-15 Create datasheet.md with driver and sensor links
    Added links to various drivers and sensors in the datasheet.
2026-03-22 Correct link formatting in README.md
    Fix markdown link formatting for batterySensor.
2026-03-22 Fix link formatting for batterySensor entry
2026-03-23 Revise sensor and voltage regulator sections
    Updated sensor and component listings in README.
2026-03-23 Fix GPIO LedDriver link in README.md
2026-04-01 Add 5V Buck Converter link to README.md
2026-04-07 Add MOSFET BMC section to README
    Added MOSFET BMC section with relevant product link.
2026-04-07 bill of material PCB design
    The key components for the PCB
2026-04-10 KiCad schematic
    Finished with the Power supply and started with the BLDC driver
2026-04-14 finished BLDC driver
2026-04-15 BLDC driver calculations
2026-04-26 Upload steering class + Update Car class
2026-04-27 Upload motor class + added comments
2026-04-29 schematic design RC_CAR
2026-04-29 Create branch + changes sensors
2026-04-29 update components
    fixed footprints and components
2026-04-30 Upload I2C class + VL53L1x class.
    WIP VL53L0x + TOF task
2026-05-01 Upload ambient temp class (mcp9808) + start motor temp class (mcp9600)
2026-05-04 Start bms class + fixed error mcp9600
2026-05-05 Start BMS code
    WIP ReadGainOffset
2026-05-12 changes PCB design and schematic
2026-05-15 restructure folders + finished ToF task for Vl53l0x sensors
2026-05-16 Update ToF task + health task + I2C DMA
    ToF task is debugged and confirmed operation for the vl53l0x, health task is created but not finished, i2c DMA is debugged and awaiting implementation in the sensor classes.
2026-05-16 converted sensor functions to use DMA
2026-07-30 Upload stl for ToF mounts + upload f3d files
2026-07-30 mechanisch design
    de toleranties verbeterd, oude staan er ook nog in moest het niet passen.
